Tahsin007m/digital-password-checker/BreadBoard.jpeg

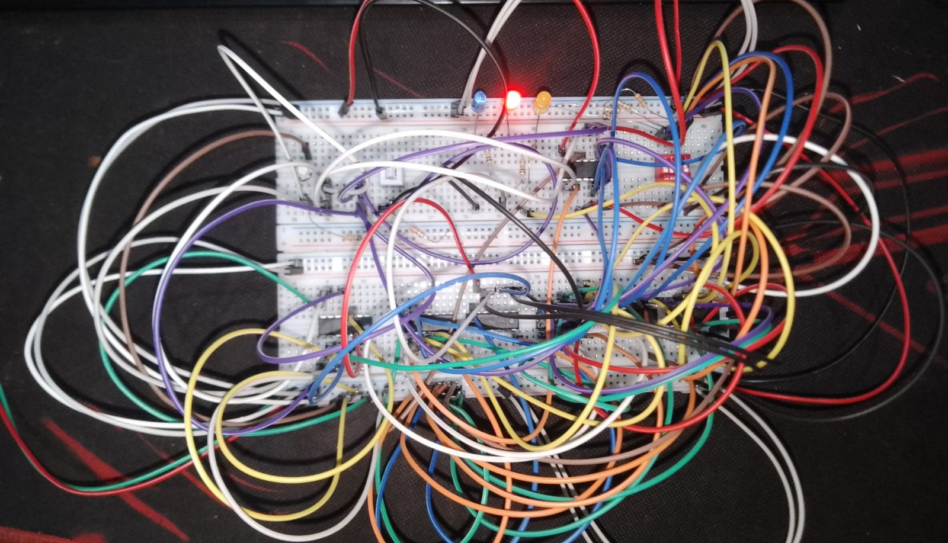
BreadBoard.jpeg
