Tahsin007m/digital-password-checker/Circuit.png

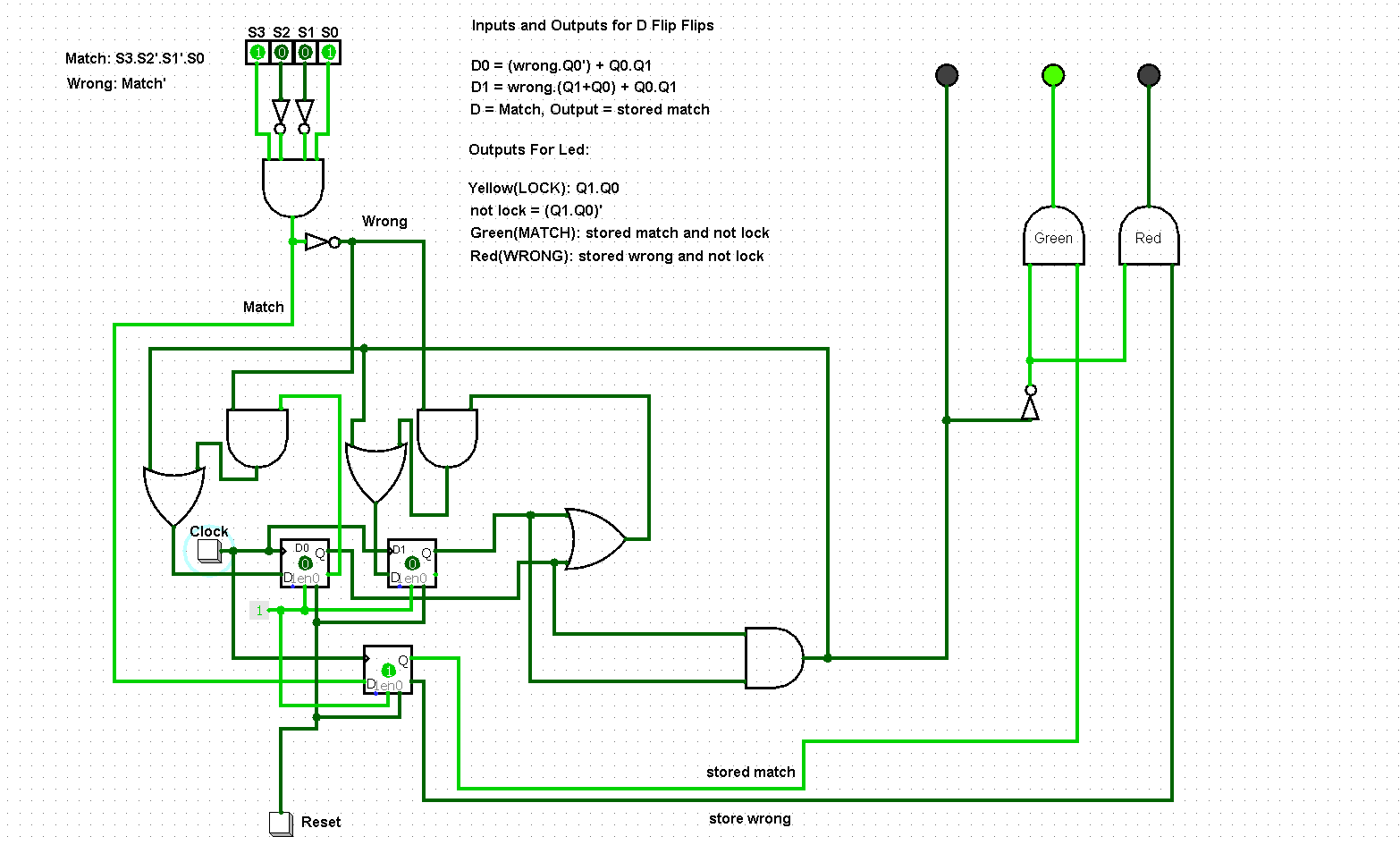
Circuit.png
