Tahsin007m/digital-password-checker/docs/State Diagram.jpeg

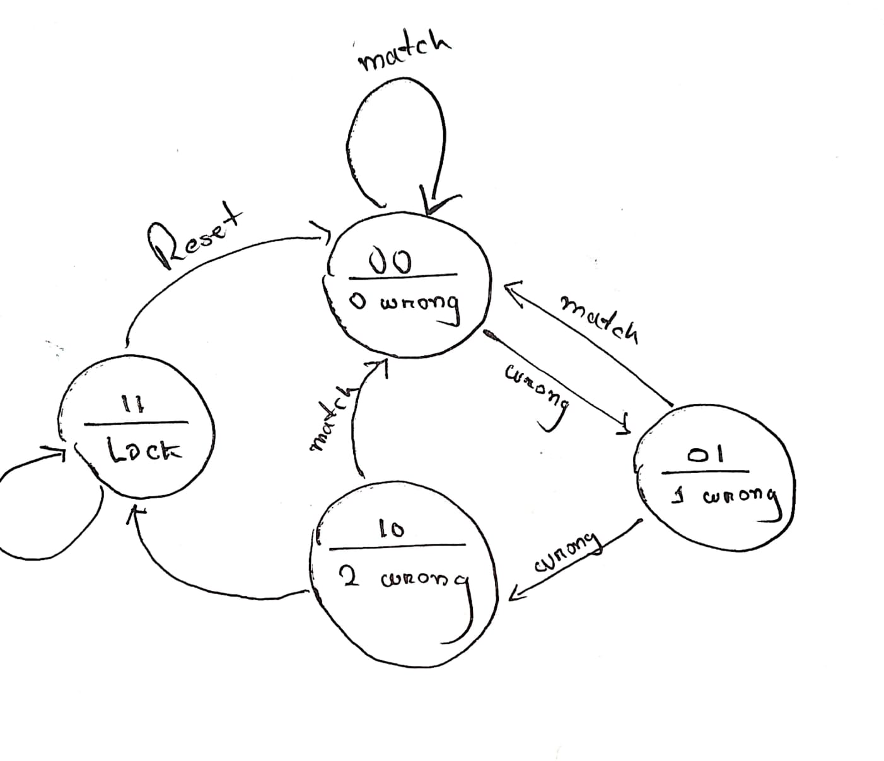
docs/State Diagram.jpeg
