Tahsin007m/digital-password-checker/docs/State Table.png

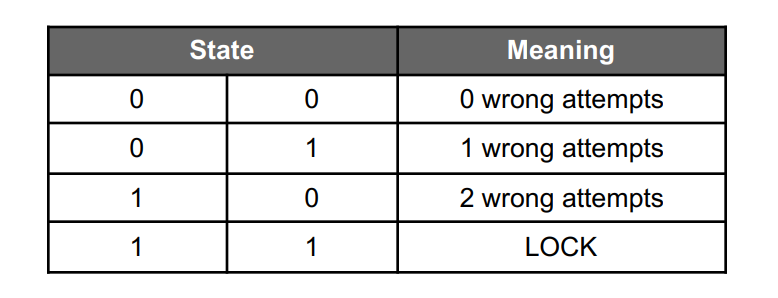
docs/State Table.png
