Tahsin007m/digital-password-checker/(list of files, drawings)

Other design files:
fsm_pass_check.circ
simulation/fsm_pass_check.circ
